turtle-bazon/PNCATEHO/light/README.md

# PNCATEHO

## PNCATEHO Welcome

### BOM

[IBOM](https://htmlpreview.github.io/?https://github.com/turtle-bazon/PNCATEHO/blob/master/light/ibom_welcome.html)

| Name | Value | Package | Quanity | JLC | Aliexpress | Misc |
| --- | --- | :--- | --- | --- | --- | --- |
| Capacitor | 1 | 0805 | 11 | [JLCPCB](https://jlcpcb.com/partdetail/39123-0805B104K500NT/C38141) | [Aliexpress](https://aliexpress.ru/item/1005008523091680.html) | |
| Capacitor | 1uF | 0805 | 4 | [JLCPCB](https://jlcpcb.com/partdetail/29074-CL21B105KBFNNNE/C28323) | [Aliexpress](https://aliexpress.ru/item/1005008523091680.html) | |
| Capacitor | 20pF | 0805 | 2 | [JLCPCB](https://jlcpcb.com/partdetail/KEMET-C0402C200K4GAC7867/C3839897) | [Aliexpress](https://aliexpress.ru/item/1005008523091680.html) | |
| Resitor | 1k | 0805 | 4 | [JLCPCB](https://jlcpcb.com/partdetail/VO-0805_1_1K/C2889437) | [Aliexpress](https://aliexpress.ru/item/1005004542788613.html)<br>  | |
| Resitor | 5.1k | 0805 | 2 | [JLCPCB](https://jlcpcb.com/partdetail/C5123602) | [Aliexpress](https://aliexpress.ru/item/1005004542788613.html)<br>  | |
| Resitor | 27Ω | 0805 | 2 | [JLCPCB](https://jlcpcb.com/partdetail/YAGEO-AC0805FR7W27RL/C5120098) | [Aliexpress](https://aliexpress.ru/item/1005004542788613.html)<br>  | |
| Resitor | 10k | 0805 | 1 | [JLCPCB](https://jlcpcb.com/partdetail/VO-0805_1_10K/C2889436) | [Aliexpress](https://aliexpress.ru/item/1005004542788613.html)<br>  | |
| LED | Red | 0805 | 1 | [JLCPCB](https://jlcpcb.com/partdetail/85425-NCD0805R1/C84256) | [Aliexpress](https://aliexpress.ru/item/4000936781234.html) | |
| LED | Blue | 0805 | 1 | [JLCPCB](https://jlcpcb.com/partdetail/Hubei_KentoElec-C2293/C2293) | [Aliexpress](https://aliexpress.ru/item/4000936781234.html) | |
| LED | WS2812B | 2020 | 20 | [JLCPCB](https://jlcpcb.com/partdetail/Worldsemi-WS2812B2020/C965555) | [Aliexpress](https://aliexpress.ru/item/1005005812058130.html)<br>  | |
| LDO | RT9013-33GB | SOT23-5 | 1 | [JLCPCB](https://jlcpcb.com/partdetail/RichtekTech-RT901333GB/C47773) | [Aliexpress](https://aliexpress.ru/item/1005009379057215.html)<br>  | |
| FLASH | W25Q32JVSSIQ | SOIC-8-208mil | 1 | [JLCPCB](https://jlcpcb.com/partdetail/WinbondElec-W25Q32JVSSIQ/C179173)<br> | [Aliexpress](https://ali.click/ja3ym8) | |
| ESD | USBLC6-2SC6 | SOT23-6 | 1 | [JLCPCB](https://jlcpcb.com/partdetail/STMicroelectronics-USBLC62SC6/C7519)<br> | [Aliexpress](https://ali.click/vl3ymq) | |
| Crystal | 12MHz 20pF | SMD3225-4P | 1 | [JLCPCB](https://jlcpcb.com/partdetail/YXC_CrystalOscillators-X322512MSB4SI/C9002)<br> | [Aliexpress](https://aliexpress.ru/item/1005006861125810.html) | |
| Fuse | 500mA 6V | 0805 | 1 | [JLCPCB](https://jlcpcb.com/partdetail/BHFUSE-BSMD0805_0506V/C883108)<br> | [Aliexpress](https://aliexpress.ru/item/1005009503064953.html) | |
| MCU | RP2040 | LQFN-56(7x7) | 1 | [JLCPCB](https://jlcpcb.com/partdetail/RaspberryPi-RP2040/C2040)<br> | [Aliexpress](https://aliexpress.ru/item/1005007523217221.html?) | |
| Type-C | TYPE-C-31-M-12 | 16P 5A Female | 1 | [JLCPCB](https://jlcpcb.com/partdetail/Korean_HropartsElec-TYPE_C_31_M12/C165948)<br>  | [Aliexpress](https://aliexpress.ru/item/1005005260008476.html?)<br> | |
| Tactile Switch | TS342A2P | SMD 4x3mm | 2 | [JLCPCB](https://jlcpcb.com/partdetail/SHOUHAN-TS342A2P/C398055) | [Aliexpress](https://ali.click/1z4ym0l)<br> | |
| Swtiches | PG1316S | SMD | 10 | [JLCPCB](https://jlcpcb.com/partdetail/Kailh-CPG1316S01D02/C42372112)<br> | | [Kailh](https://www.kailhswitch.com/mechanical-keyboard-switches/low-profile-key-switches/kailh-ultra-thin-notebook-switch.html) |
| Sockets (Optional) | PBS | PH8.5 | 10 pin  | | [Aliexpress](https://aliexpress.ru/item/1005001621924231.html)<br>  | |
| Pin (Optional) | PLS | | 10 Pin  | | [Aliexpress](https://aliexpress.ru/item/1005001708024520.html)<br>  | |
| JST (Optional) | SM10B-GHS-TB | P=1.25mm,Surface Mount，Right Angle | 2 | [JLCPCB](https://jlcpcb.com/partdetail/JST-SM10B_GHSTB/C2683602)<br> | <br> | [ChipDip](https://www.chipdip.ru/product/sm10b-ghs-tb-connector-header-surface-mount-right-angle-jst-8033862895) |
