turtle-bazon/PNCATEHO/glass/case/MK_DOSE/PNCATEHO_MK_DOSE-case-top-cover-JP-katakana-right-lp.step

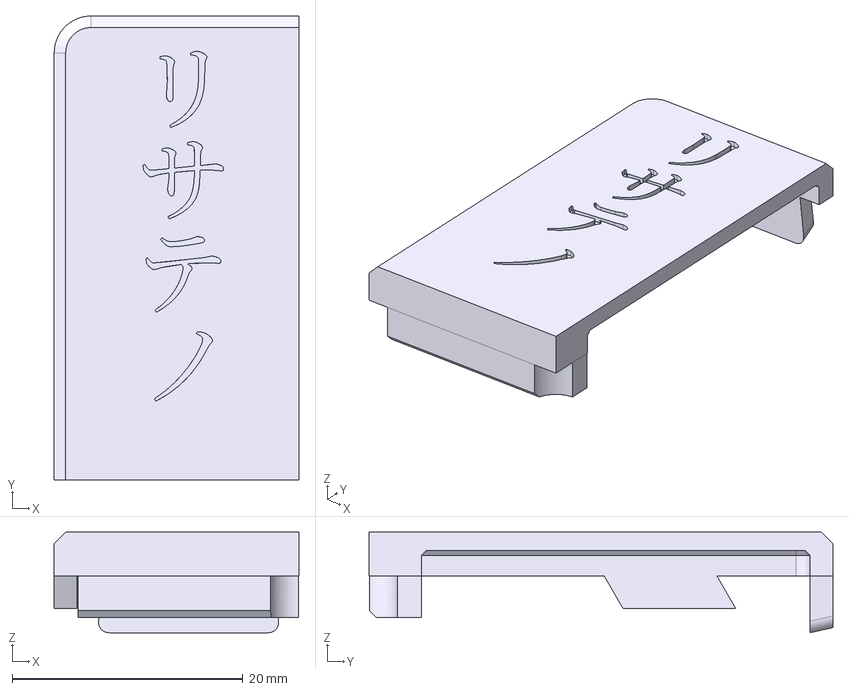
[picture p1: CAD file, 2025-09-07]
glass/case/MK_DOSE/PNCATEHO_MK_DOSE-case-top-cover-JP-katakana-right-lp.step
21.2 x 40.2 x 8.71 mm
