turtle-bazon/PNCATEHO/glass/case/v5/PNCATEHO_v5-bottom-case-left.step

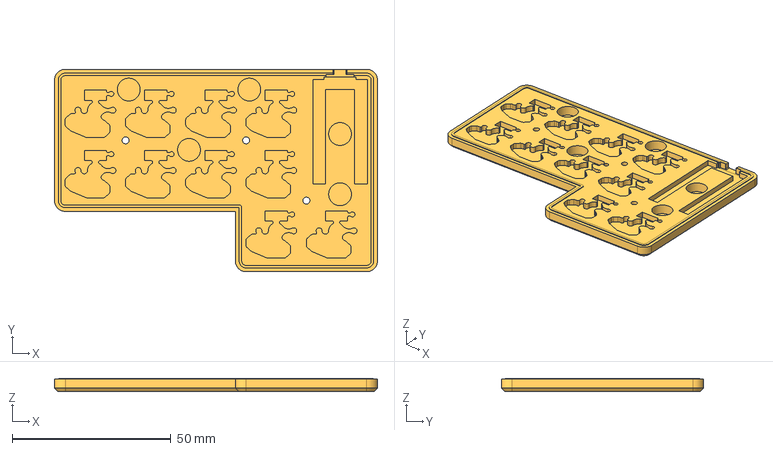
[picture p2: CAD file, 2025-08-24]
glass/case/v5/PNCATEHO_v5-bottom-case-left.step
101.8 x 63.8 x 4.20 mm
