turtle-bazon/PNCATEHO/light/pcb/PNCATEHO_lib/step/SW_SPST_B3U-1000P-B.step

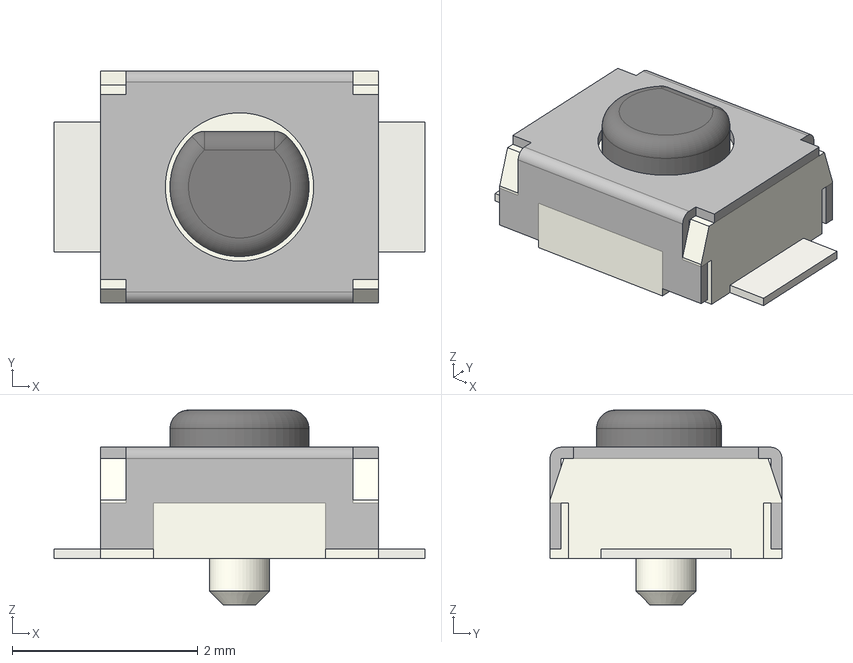
[picture p3: CAD file, 2025-08-21]
light/pcb/PNCATEHO_lib/step/SW_SPST_B3U-1000P-B.step
4.00 x 2.50 x 2.10 mm
