turtle-bazon/PNCATEHO/light/pcb/PNCATEHO_lib/step/Fuse_0805_2012Metric.step

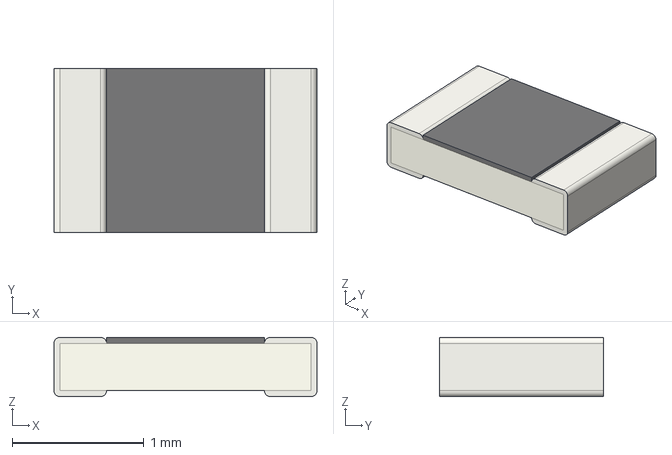
[picture p6: CAD file, 2025-08-20]
light/pcb/PNCATEHO_lib/step/Fuse_0805_2012Metric.step
2.00 x 1.25 x 0.45 mm
