turtle-bazon/PNCATEHO/light/pcb/PNCATEHO_lib/step/TYPE-C-31-M-12--3DModel-STEP-56544.STEP

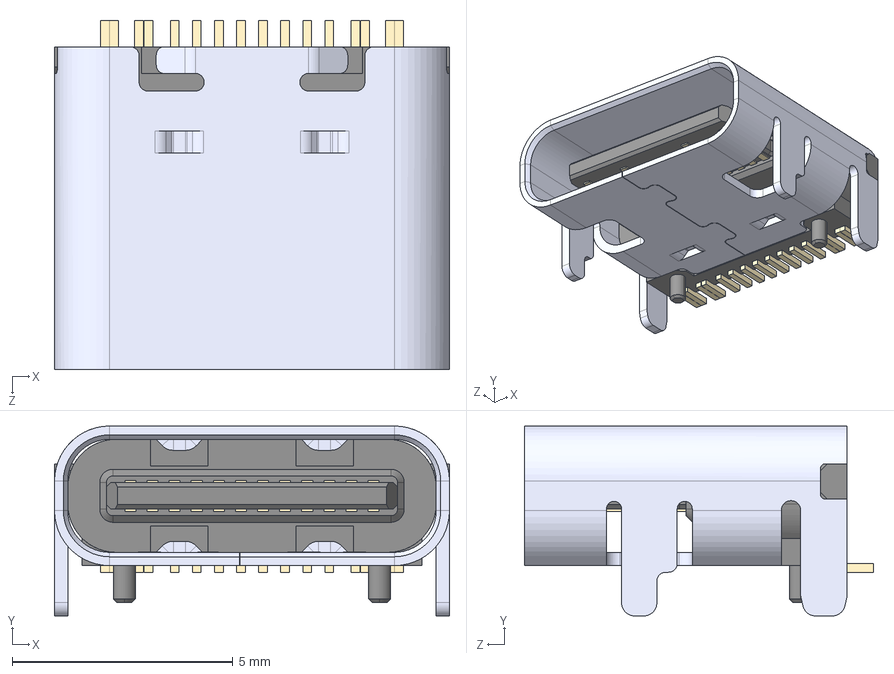
[picture p7: CAD file, 2025-08-20]
light/pcb/PNCATEHO_lib/step/TYPE-C-31-M-12--3DModel-STEP-56544.STEP
8.94 x 4.30 x 7.90 mm
