turtle-bazon/PNCATEHO/light/pcb/PNCATEHO_lib/step/W25Q32JVSSIQ--3DModel-STEP-269445.STEP

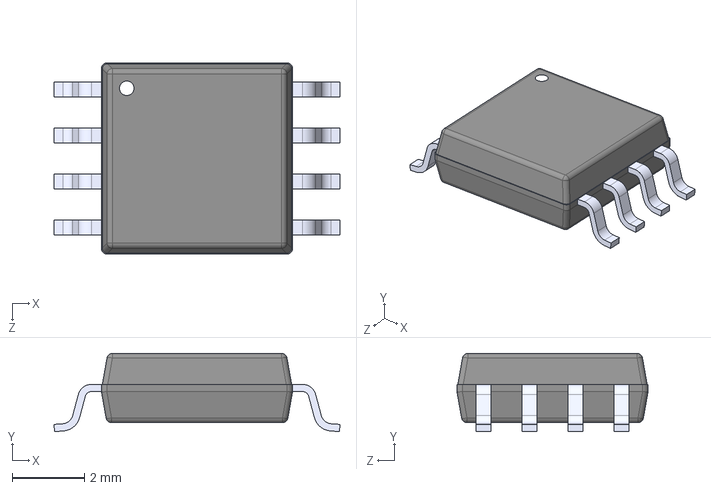
[picture p9: CAD file, 2025-08-20]
light/pcb/PNCATEHO_lib/step/W25Q32JVSSIQ--3DModel-STEP-269445.STEP
7.90 x 2.16 x 5.28 mm
