turtle-bazon/PNCATEHO/light/pcb/PNCATEHO_lib/step/D_0805_2012Metric.step

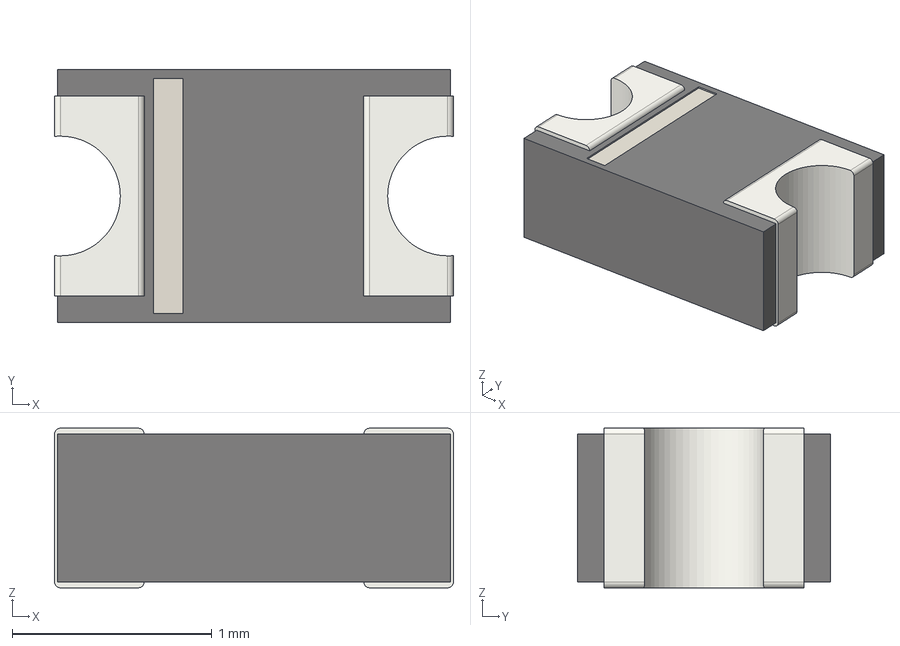
[picture p10: CAD file, 2025-08-20]
light/pcb/PNCATEHO_lib/step/D_0805_2012Metric.step
2.00 x 1.27 x 0.8 mm
