turtle-bazon/PNCATEHO/light/pcb/PNCATEHO_lib/step/RT9013-33GB.STEP

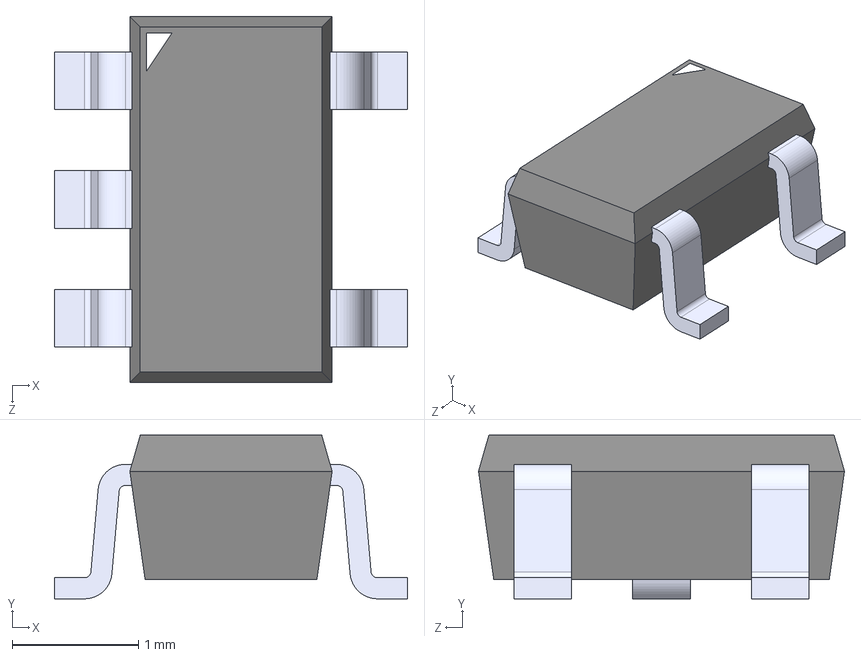
[picture p12: CAD file, 2025-08-20]
light/pcb/PNCATEHO_lib/step/RT9013-33GB.STEP
2.79 x 1.30 x 2.90 mm
