turtle-bazon/PNCATEHO/light/pcb/PNCATEHO_lib/step/Crystal_SMD_3225-4Pin_3.2x2.5mm.step

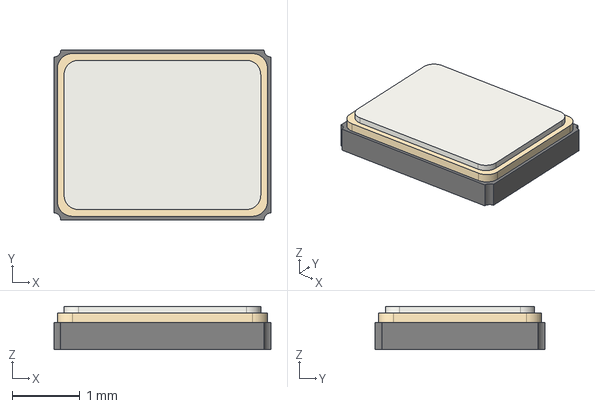
[picture p13: CAD file, 2025-08-20]
light/pcb/PNCATEHO_lib/step/Crystal_SMD_3225-4Pin_3.2x2.5mm.step
3.20 x 2.50 x 0.64 mm
