turtle-bazon/PNCATEHO/light/pcb/PNCATEHO_lib/step/R_0805_2012Metric.step

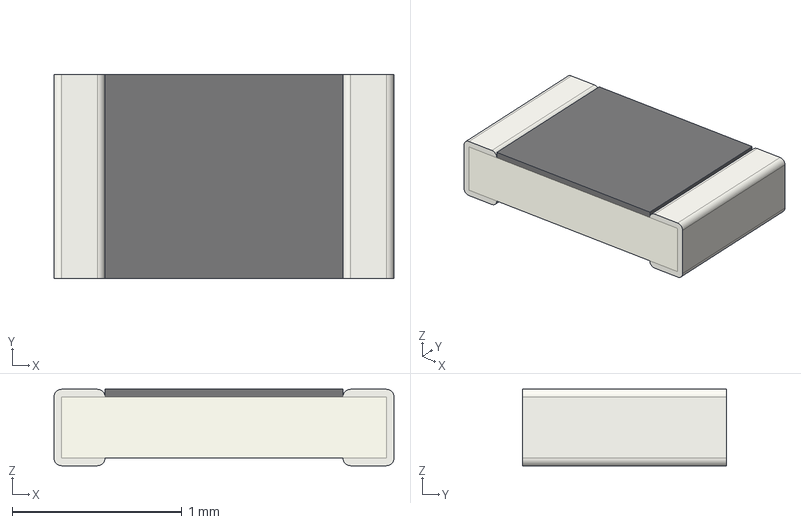
[picture p16: CAD file, 2025-08-20]
light/pcb/PNCATEHO_lib/step/R_0805_2012Metric.step
2.00 x 1.20 x 0.45 mm
