turtle-bazon/PNCATEHO/(list of files, cad)

Other CAD files:
glass/case/v5/PNCATEHO_v5-bottom-case-right.step
glass/case/MK_DOSE/PNCATEHO_MK_DOSE-case-top-cover-JP-katakana-left-lp.step
glass/case/MK_DOSE/PNCATEHO_MK_DOSE-case-top-cover-blank-right-lp.step
glass/case/MK_DOSE/PNCATEHO_MK_DOSE-case-bottom-left.step
