turtle-bazon/PNCATEHO/light/pcb/PNCATEHO_Welcome/PNCATEHO_Welcome.kicad_pcb

## KiCad design light/pcb/PNCATEHO_Welcome/PNCATEHO_Welcome.kicad_pcb (2025-10-24)

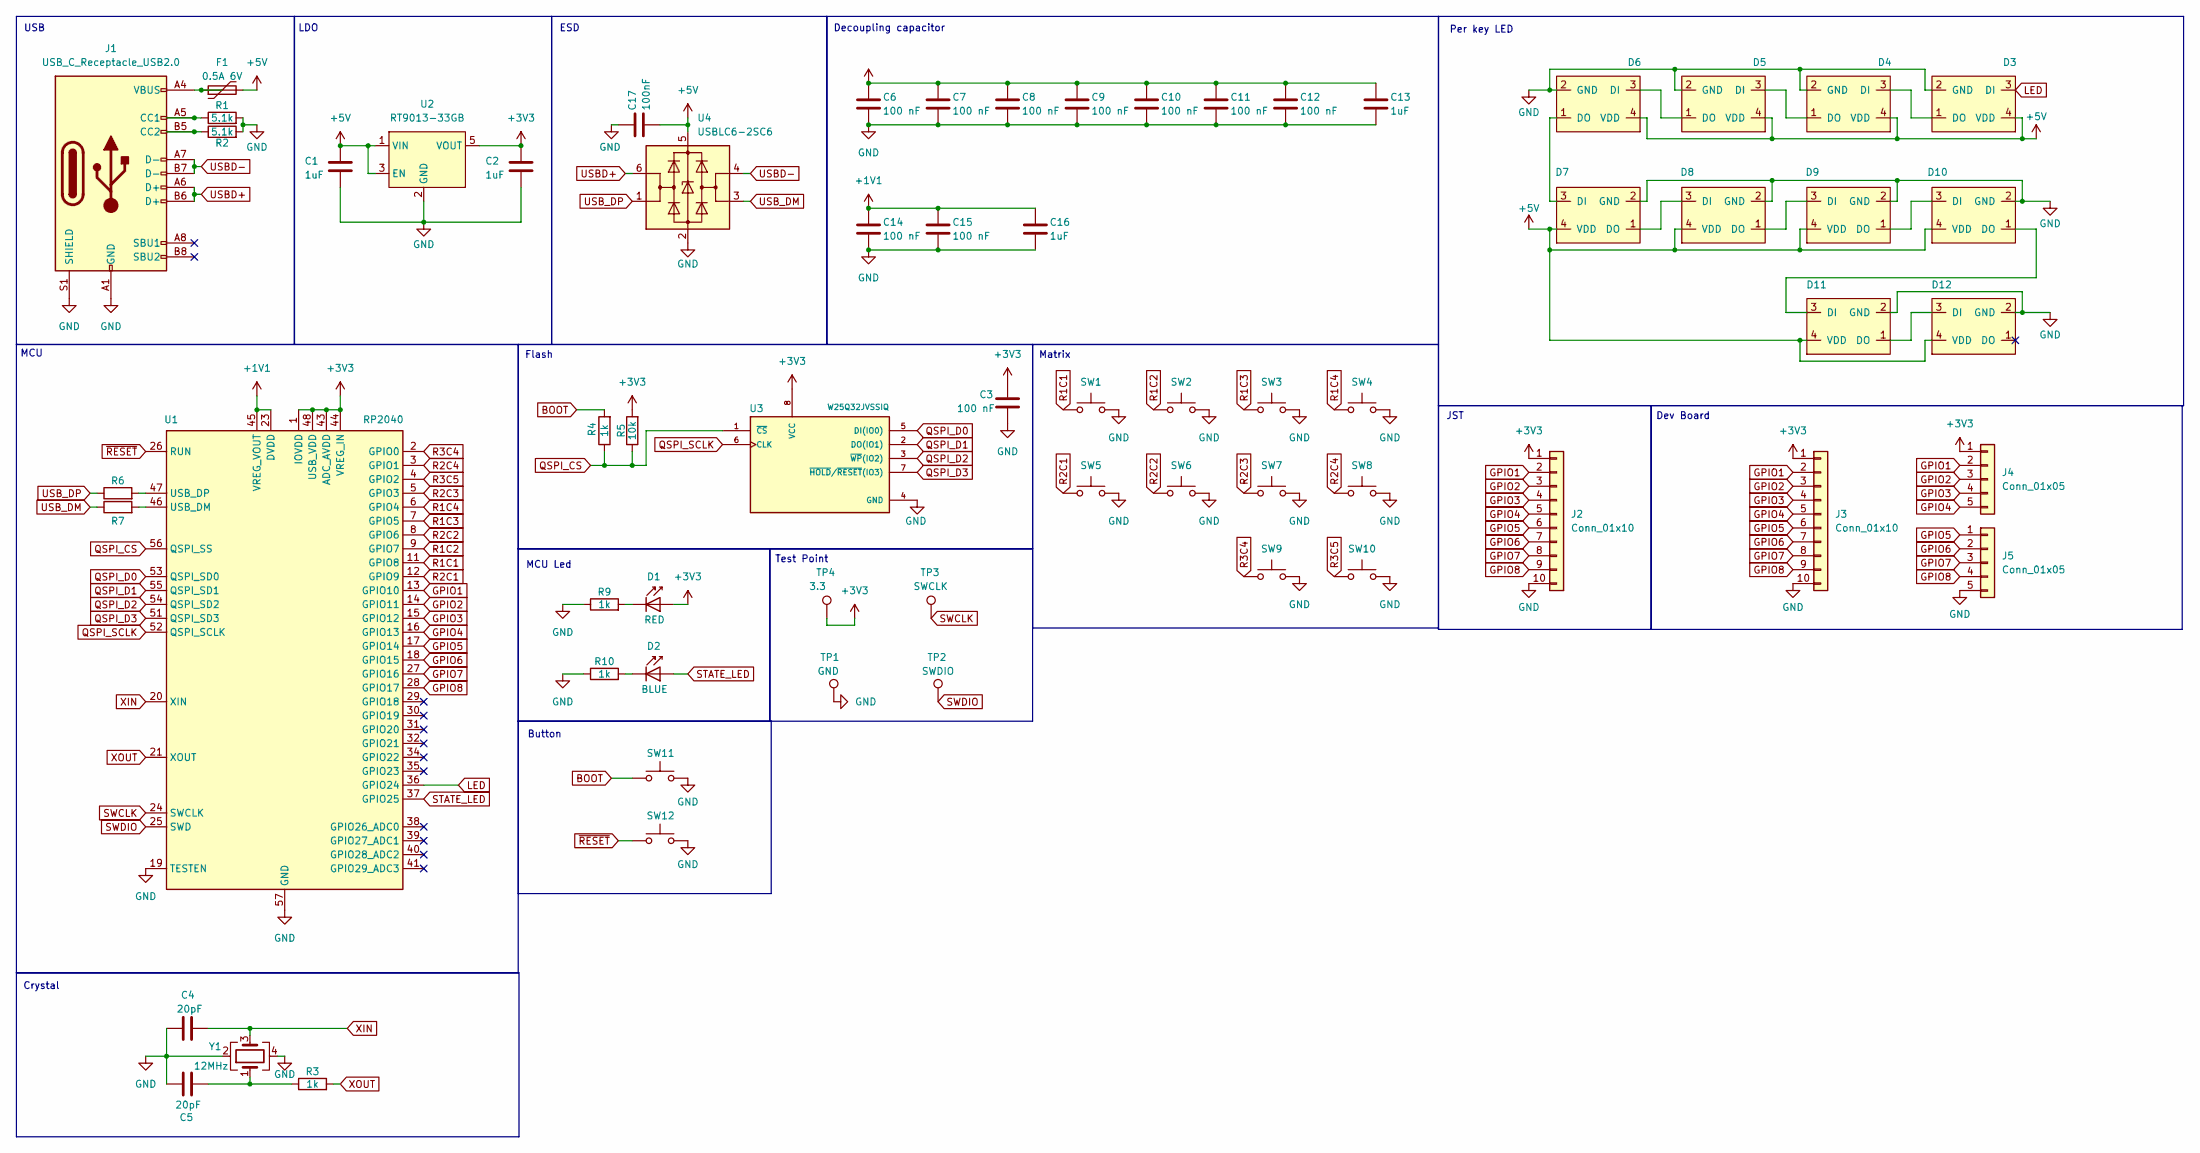
[picture p17: schematic PNCATEHO_Welcome.kicad_sch]

Parts:
C1, C2, C13, C16: 1uF; C_0805_2012Metric_Pad1.18x1.45mm_HandSolder
C3, C6, C7, C8, C9, C10, C11, C12, C14, C15: 100 nF; C_0805_2012Metric_Pad1.18x1.45mm_HandSolder
C4, C5: 20pF; C_0805_2012Metric_Pad1.18x1.45mm_HandSolder
C17: 100nF; C_0805_2012Metric_Pad1.18x1.45mm_HandSolder
D1: RED; LED_0805_2012Metric_Pad1.15x1.40mm_HandSolder
D2: BLUE; LED_0805_2012Metric_Pad1.15x1.40mm_HandSolder
D3, D4, D5, D6, D7, D8, D9, D10, D11, D12: WS2812-2020-2.00mmx2.20mm
F1: 0.5А 6V; Fuse_0805_2012Metric_Pad1.15x1.40mm_HandSolder
J1: USB_C_Receptacle_USB2.0; USB_C_Receptacle_TYPE-C-31-M-12
J2, J3: Conn_01x10; JST_GH_SM10B-GHS-TB_1x10-1MP_P1.25mm_Horizontal
J4, J5: Conn_01x05; PinHeader_1x05_P2.54mm_Vertical
R1, R2: 5.1k; R_0805_2012Metric_Pad1.20x1.40mm_HandSolder
R3, R4, R9, R10: 1k; R_0805_2012Metric_Pad1.20x1.40mm_HandSolder
R5: 10k; R_0805_2012Metric_Pad1.20x1.40mm_HandSolder
R6, R7: 27; R_0805_2012Metric_Pad1.20x1.40mm_HandSolder
SW1, SW2, SW3, SW4, SW5, SW6, SW7, SW8, SW9, SW10: SW_PG1316
SW11: Boot; SW_PUSH
SW12: Reset; SW_PUSH
TP1: GND; TestPoint_Pad_1.0x1.0mm
TP2: SWDIO; TestPoint_Pad_D1.0mm
TP3: SWCLK; TestPoint_Pad_D1.0mm
TP4: 3.3; TestPoint_Pad_D1.0mm
U1: RP2040; QFN-56-1EP_7x7mm_P0.4mm_EP3.2x3.2mm_ThermalVias
U2: RT9013-33GB; SOT-23-5_HandSoldering
U3: W25Q32JVSSIQ; SOIC-8_5.3x5.3mm_P1.27mm; M_PART_NUMBER W25QXX
U4: USBLC6-2SC6; SOT-23-6_Handsoldering
Y1: 12MHz; Crystal_SMD_3225-4Pin_3.2x2.5mm_HandSoldering

Connections:
+1V1: C14.1, C15.1, C16.1, U1.23 (DVDD), U1.45 (VREG_VOUT), U1.50 (DVDD)
+3V3: C2.1, C3.1, C6.1, C7.1, C8.1, C9.1, C10.1, C11.1, C12.1, C13.1, D1.2 (A), J2.1, J3.1, J4.1, R5.2, TP4.1, U1.1 (IOVDD), U1.10 (IOVDD), U1.22 (IOVDD), U1.33 (IOVDD), U1.42 (IOVDD), U1.43 (ADC_AVDD), U1.44 (VREG_IN), U1.48 (USB_VDD), U1.49 (IOVDD), U2.5 (VOUT), U3.8 (VCC)
+5V: C1.1, C17.2, D3.4 (VDD), D4.4 (VDD), D5.4 (VDD), D6.4 (VDD), D7.4 (VDD), D8.4 (VDD), D9.4 (VDD), D10.4 (VDD), D11.4 (VDD), D12.4 (VDD), F1.2, U2.1 (VIN), U2.3 (EN), U4.5 (VBUS)
BOOT: R4.2, SW11.2
GND: C1.2, C2.2, C3.2, C4.2, C5.2, C6.2, C7.2, C8.2, C9.2, C10.2, C11.2, C12.2, C13.2, C14.2, C15.2, C16.2, C17.1, D3.2 (GND), D4.2 (GND), D5.2 (GND), D6.2 (GND), D7.2 (GND), D8.2 (GND), D9.2 (GND), D10.2 (GND), D11.2 (GND), D12.2 (GND), J1.A1 (GND), J1.A12 (GND), J1.B1 (GND), J1.B12 (GND), J1.S1 (SHIELD), J2.10, J3.10, J5.5, R1.2, R2.2, R9.1, R10.1, SW1.2, SW2.2, SW3.2, SW4.2, SW5.2, SW6.2, SW7.2, SW8.2, SW9.2, SW10.2, SW11.1, SW12.1, TP1.1, U1.19 (TESTEN), U1.57 (GND), U2.2 (GND), U3.4 (GND), U4.2 (GND), Y1.2, Y1.4
GPIO1: J2.2, J3.2, J4.2, U1.13 (GPIO10)
GPIO2: J2.3, J3.3, J4.3, U1.14 (GPIO11)
GPIO3: J2.4, J3.4, J4.4, U1.15 (GPIO12)
GPIO4: J2.5, J3.5, J4.5, U1.16 (GPIO13)
GPIO5: J2.6, J3.6, J5.1, U1.17 (GPIO14)
GPIO6: J2.7, J3.7, J5.2, U1.18 (GPIO15)
GPIO7: J2.8, J3.8, J5.3, U1.27 (GPIO16)
GPIO8: J2.9, J3.9, J5.4, U1.28 (GPIO17)
LED: D3.3 (DI), U1.36 (GPIO24)
unnamed: C5.1, R3.1, Y1.1
unnamed: D1.1 (K), R9.2
unnamed: D2.1 (K), R10.2
unnamed: D3.1 (DO), D4.3 (DI)
unnamed: D4.1 (DO), D5.3 (DI)
unnamed: D5.1 (DO), D6.3 (DI)
unnamed: D6.1 (DO), D7.3 (DI)
unnamed: D7.1 (DO), D8.3 (DI)
unnamed: D8.1 (DO), D9.3 (DI)
unnamed: D9.1 (DO), D10.3 (DI)
unnamed: D10.1 (DO), D11.3 (DI)
unnamed: D11.1 (DO), D12.3 (DI)
unnamed: F1.1, J1.A4 (VBUS), J1.A9 (VBUS), J1.B4 (VBUS), J1.B9 (VBUS)
unnamed: J1.A5 (CC1), R1.1
unnamed: J1.B5 (CC2), R2.1
unnamed: R7.2, U1.46 (USB_DM)
unnamed: R6.2, U1.47 (USB_DP)
QSPI_CS: R4.1, R5.1, U1.56 (QSPI_SS), U3.1 (~CS)
QSPI_D0: U1.53 (QSPI_SD0), U3.5 (DI(IO0))
QSPI_D1: U1.55 (QSPI_SD1), U3.2 (DO(IO1))
QSPI_D2: U1.54 (QSPI_SD2), U3.3 (~WP(IO2))
QSPI_D3: U1.51 (QSPI_SD3), U3.7 (~HOLD/~RESET(IO3))
QSPI_SCLK: U1.52 (QSPI_SCLK), U3.6 (CLK)
R1C1: SW1.1, U1.11 (GPIO8)
R1C2: SW2.1, U1.9 (GPIO7)
R1C3: SW3.1, U1.7 (GPIO5)
R1C4: SW4.1, U1.6 (GPIO4)
R2C1: SW5.1, U1.12 (GPIO9)
R2C2: SW6.1, U1.8 (GPIO6)
R2C3: SW7.1, U1.5 (GPIO3)
R2C4: SW8.1, U1.3 (GPIO1)
R3C4: SW9.1, U1.2 (GPIO0)
R3C5: SW10.1, U1.4 (GPIO2)
STATE_LED: D2.2 (A), U1.37 (GPIO25)
SWCLK: TP3.1, U1.24 (SWCLK)
SWDIO: TP2.1, U1.25 (SWD)
USBD+: J1.A6 (D+), J1.B6 (D+), U4.6 (I/O1)
USBD-: J1.A7 (D-), J1.B7 (D-), U4.4 (I/O2)
USB_DM: R7.1, U4.3 (I/O2)
USB_DP: R6.1, U4.1 (I/O1)
XIN: C4.1, U1.20 (XIN), Y1.3
XOUT: R3.2, U1.21 (XOUT)
~RESET: SW12.2, U1.26 (RUN)

Notes on the sheet:
ESD
Test Point
Per key LED
MCU Led
Dev Board
Crystal
USB
MCU
Flash
LDO
Decoupling capacitor
JST
Button
Matrix

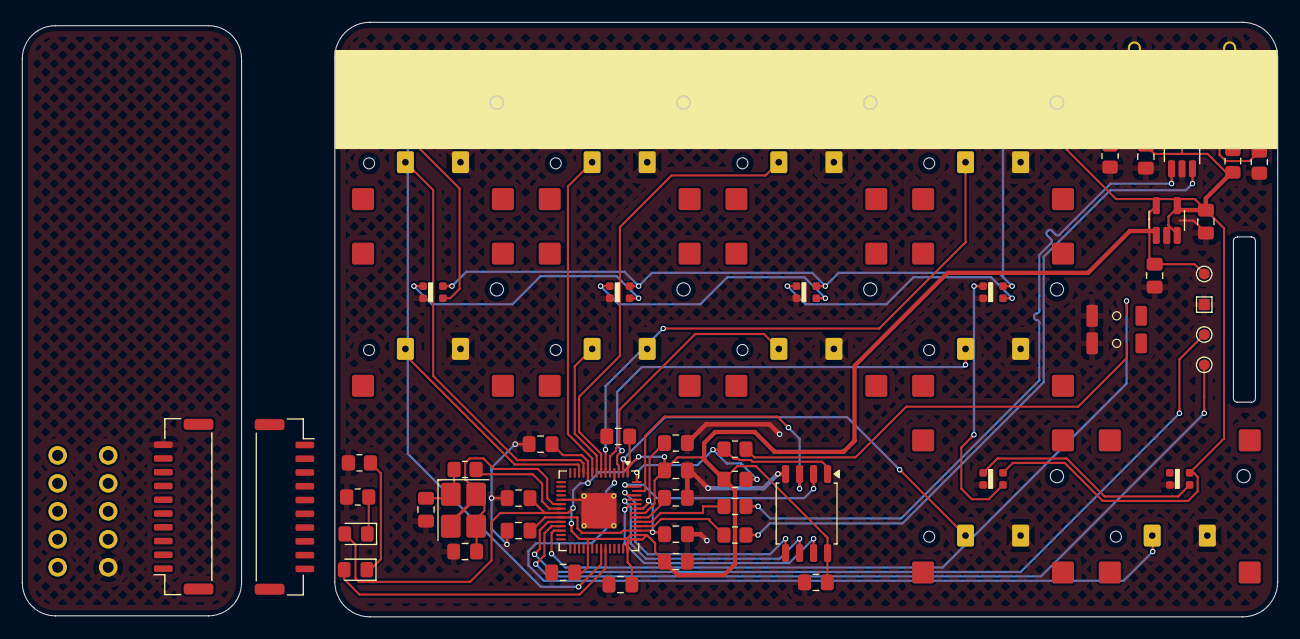
[picture p18: board PNCATEHO_Welcome.kicad_pcb from above]

Board: 2 copper layers, 85.6 x 54.0 mm, 65 parts (0 on the bottom side), 57 nets.
