turtle-bazon/PNCATEHO/light/pcb/PNCATEHO_lowair/PNCATEHO_lowair.kicad_pcb

## KiCad design light/pcb/PNCATEHO_lowair/PNCATEHO_lowair.kicad_pcb (2025-10-20)

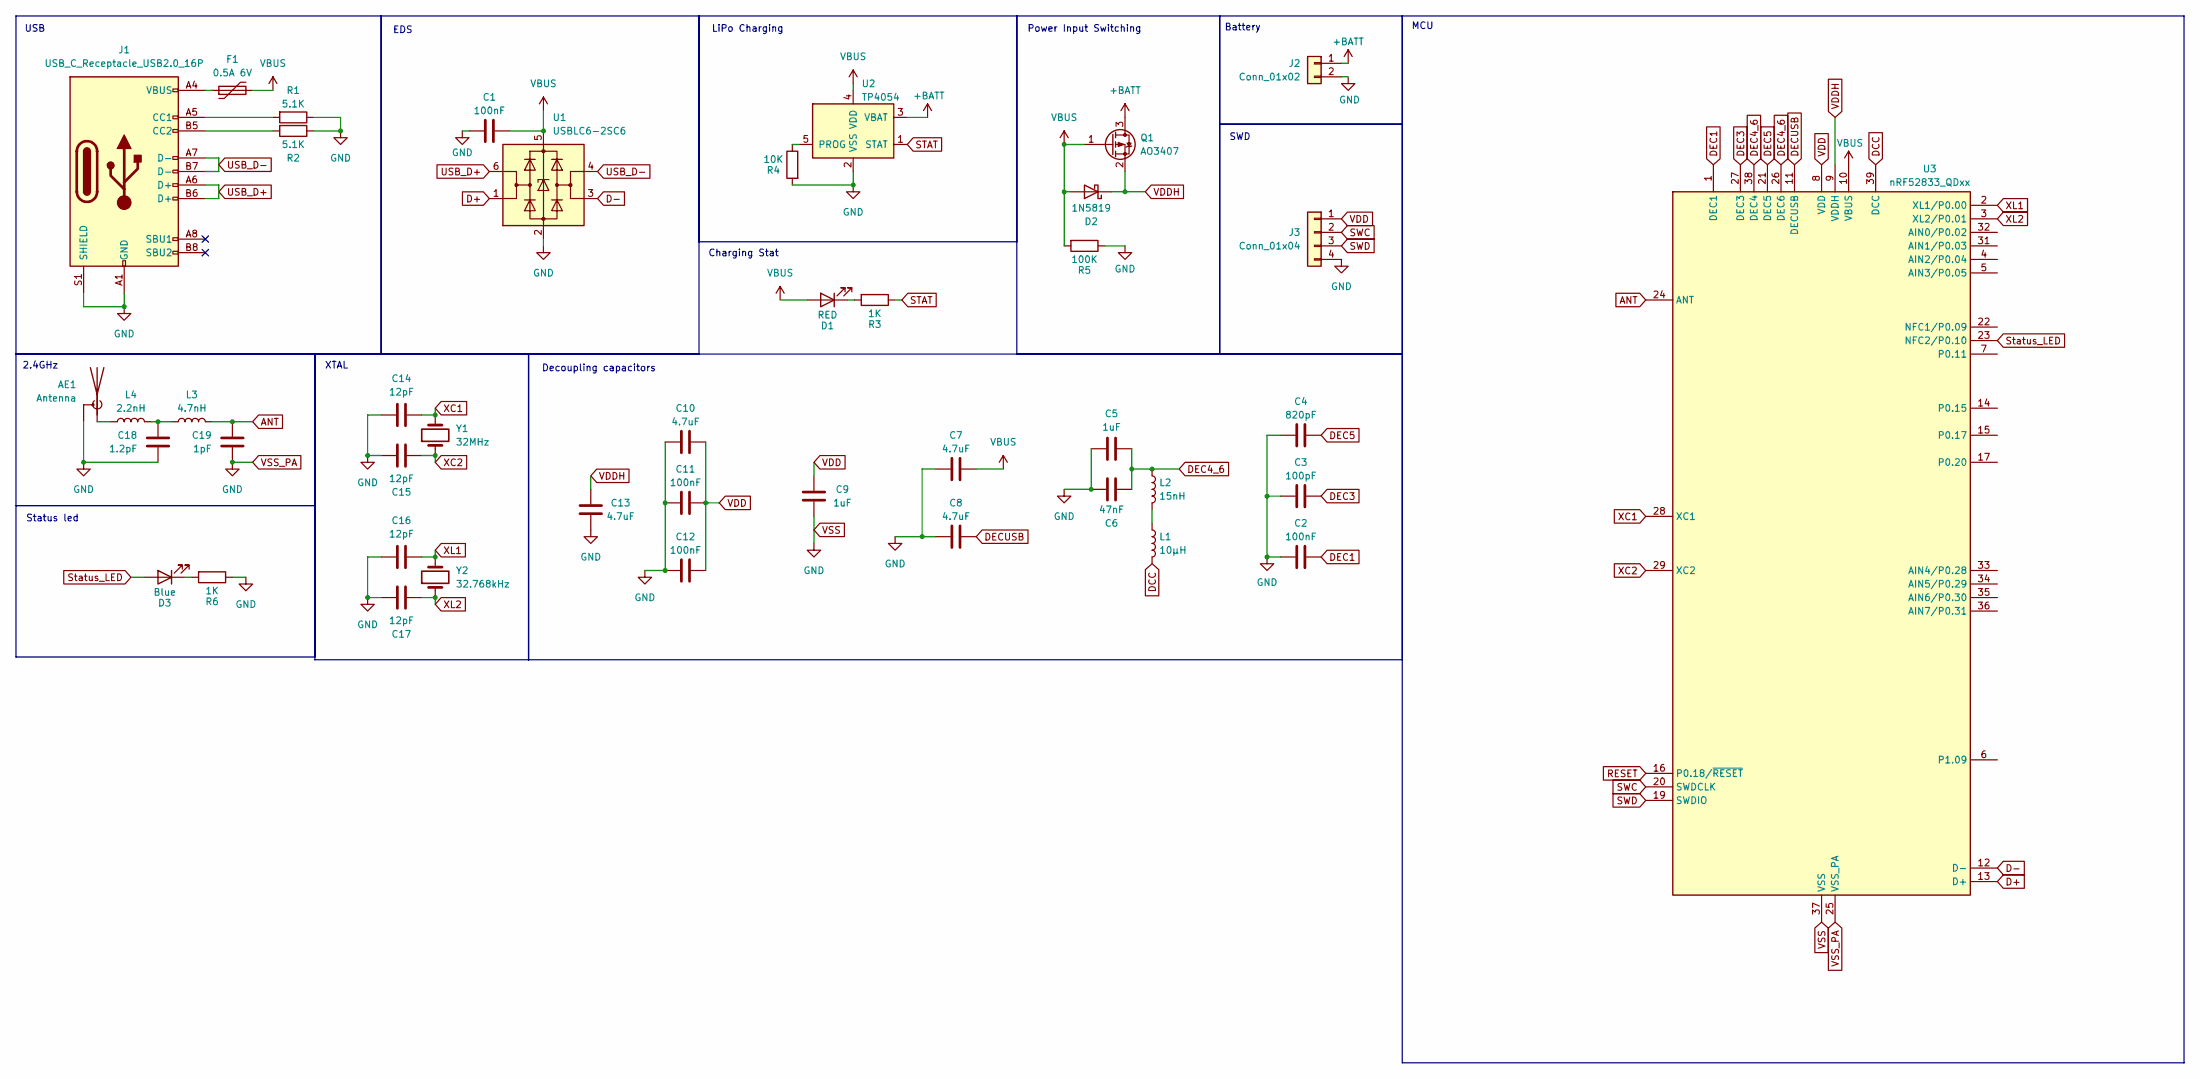
[picture p19: schematic PNCATEHO_lowair.kicad_sch]

Parts:
AE1: Antenna; Texas_SWRA117D_2.4GHz_Left
C1, C2, C11, C12: 100nF; C_0201_0603Metric_Pad0.64x0.40mm_HandSolder
C3: 100pF; C_0201_0603Metric_Pad0.64x0.40mm_HandSolder
C4: 820pF; C_0201_0603Metric_Pad0.64x0.40mm_HandSolder
C5, C9: 1uF; C_0402_1005Metric_Pad0.74x0.62mm_HandSolder
C6: 47nF; C_0201_0603Metric_Pad0.64x0.40mm_HandSolder
C7, C8, C10, C13: 4.7uF; C_0603_1608Metric_Pad1.08x0.95mm_HandSolder
C14, C15, C16, C17: 12pF; C_0201_0603Metric_Pad0.64x0.40mm_HandSolder
C18: 1.2pF; C_0201_0603Metric_Pad0.64x0.40mm_HandSolder
C19: 1pF; C_0201_0603Metric_Pad0.64x0.40mm_HandSolder
D1: RED; LED_0805_2012Metric_Pad1.15x1.40mm_HandSolder
D2: 1N5819; D_SOD-323_HandSoldering
D3: Blue; LED_0805_2012Metric_Pad1.15x1.40mm_HandSolder
F1: 0.5А 6V; Fuse_1206_3216Metric_Pad1.42x1.75mm_HandSolder
J1: USB_C_Receptacle_USB2.0_16P; USB_C_Receptacle_TYPE-C-31-M-12
J2: Conn_01x02
J3: Conn_01x04; connector_swd_REV
L1: 10μH; L_0603_1608Metric_Pad1.05x0.95mm_HandSolder
L2: 15nH; L_0402_1005Metric_Pad0.77x0.64mm_HandSolder
L3: 4.7nH; L_0201_0603Metric_Pad0.64x0.40mm_HandSolder
L4: 2.2nH; L_0201_0603Metric_Pad0.64x0.40mm_HandSolder
Q1: AO3407; SOT-23
R1, R2: 5.1K; R_0603_1608Metric_Pad0.98x0.95mm_HandSolder
R3, R6: 1K; R_0603_1608Metric_Pad0.98x0.95mm_HandSolder
R4: 10K; R_0603_1608Metric_Pad0.98x0.95mm_HandSolder
R5: 100K; R_0603_1608Metric_Pad0.98x0.95mm_HandSolder
U1: USBLC6-2SC6; SOT-23-6
U2: TP4054; SOT-23-5
U3: nRF52833_QDxx; QFN-40-1EP_5x5mm_P0.4mm_EP3.6x3.6mm_ThermalVias
Y1: 32MHz
Y2: 32.768kHz

Connections:
+BATT: J2.1, Q1.3 (D), U2.3 (VBAT)
ANT: C19.2, L3.1, U3.24 (ANT)
D+: U1.1 (I/O1), U3.13 (D+)
D-: U1.3 (I/O2), U3.12 (D-)
DCC: L1.2, U3.39 (DCC)
DEC1: C2.2, U3.1 (DEC1)
DEC3: C3.2, U3.27 (DEC3)
DEC4_6: C5.2, C6.2, L2.1, U3.26 (DEC6), U3.38 (DEC4)
DEC5: C4.2, U3.21 (DEC5)
DECUSB: C8.2, U3.11 (DECUSB)
unnamed: AE1.1 (A), L4.2
unnamed: C18.1, L3.2, L4.1
unnamed: D1.1 (K), R3.2
unnamed: D3.1 (K), R6.2
unnamed: F1.1, J1.A4 (VBUS), J1.A9 (VBUS), J1.B4 (VBUS), J1.B9 (VBUS)
unnamed: J1.A5 (CC1), R1.2
unnamed: J1.B5 (CC2), R2.2
unnamed: L1.1, L2.2
unnamed: R4.1, U2.5 (PROG)
RESET: U3.16 (P0.18/~RESET)
STAT: R3.1, U2.1 (STAT)
SWC: J3.2, U3.20 (SWDCLK)
SWD: J3.3, U3.19 (SWDIO)
Status_LED: D3.2 (A), U3.23 (NFC2/P0.10)
USB_D+: J1.A6 (D+), J1.B6 (D+), U1.6 (I/O1)
USB_D-: J1.A7 (D-), J1.B7 (D-), U1.4 (I/O2)
VBUS: C1.2, C7.2, D1.2 (A), D2.2 (A), F1.2, Q1.1 (G), R5.2, U1.5 (VBUS), U2.4 (VDD), U3.10 (VBUS)
VDD: C9.1, C10.2, C11.2, C12.2, J3.1, U3.8 (VDD), U3.18 (VDD), U3.30 (VDD), U3.40 (VDD)
VDDH: C13.1, D2.1 (K), Q1.2 (S), U3.9 (VDDH)
VSS: AE1.2 (Shield), C1.1, C2.1, C3.1, C4.1, C5.1, C6.1, C7.1, C8.1, C9.2, C10.1, C11.1, C12.1, C13.2, C14.1, C15.2, C16.1, C17.2, C18.2, C19.1, J1.A1 (GND), J1.A12 (GND), J1.B1 (GND), J1.B12 (GND), J1.S1 (SHIELD), J2.2, J3.4, R1.1, R2.1, R4.2, R5.1, R6.1, U1.2 (GND), U2.2 (VSS), U3.25 (VSS_PA), U3.37 (VSS), U3.41 (VSS)
XC1: C14.2, U3.28 (XC1), Y1.2
XC2: C15.1, U3.29 (XC2), Y1.1
XL1: C16.2, U3.2 (XL1/P0.00), Y2.2
XL2: C17.1, U3.3 (XL2/P0.01), Y2.1

Notes on the sheet:
EDS
Status led
Power Input Switching
USB
LiPo Charging
XTAL
2.4GHz
Charging Stat
SWD
Battery
Decoupling capacitors
MCU

Board: 2 copper layers, 40 parts (0 on the bottom side), 33 nets, no tracks yet.
