turtle-bazon/PNCATEHO/(commit log)

2025-08-20 upload sheme
    [PNCATEHO.kicad_pcb, PNCATEHO.kicad_sch]
2025-08-21 PGS1316s PNCATEHO basic routing
    [PNCATEHO.kicad_pcb, PNCATEHO.kicad_sch]
2025-08-21 update routin
    [PNCATEHO.kicad_pcb]
2025-08-21 update silkscreen
2025-08-21 update solid
    [PNCATEHO.kicad_pcb]
2025-08-21 update step
    [PNCATEHO.kicad_pcb]
2025-08-21 fix footprint
    [PNCATEHO.kicad_pcb]
2025-08-22 update outline
    [PNCATEHO.kicad_pcb, PNCATEHO.kicad_sch]
2025-08-24 Change default Silicone Pad Diameter to 8mm
    [PNCATEHO_MK_DOSE-case-bottom-left.step, PNCATEHO_MK_DOSE-case-bottom-right.step, PNCATEHO_v5-bottom-case-left.step, PNCATEHO_v5-bottom-case-right.step]
2025-08-24 Some little fixes
    [PNCATEHO.kicad_pcb, PNCATEHO.kicad_sch]
2025-08-25 Add production files to ignore
    [PNCATEHO.kicad_pcb]
2025-08-28 add esd protection
    [PNCATEHO.kicad_pcb, PNCATEHO.kicad_sch]
2025-08-28 add some fix
    [PNCATEHO.kicad_pcb, PNCATEHO.kicad_sch]
2025-08-28 remove reset button
    [PNCATEHO.kicad_pcb, PNCATEHO.kicad_sch]
2025-08-28 change design
    [PNCATEHO.kicad_pcb]
2025-08-28 remove led
    [PNCATEHO.kicad_pcb, PNCATEHO.kicad_sch]
2025-08-28 add button
    [PNCATEHO.kicad_pcb, PNCATEHO.kicad_sch]
2025-08-29 * components moved closer to each other; * rerouted with esd protection; * fixed usb data differential pair length; * changed design to be like a credit card;
    [PNCATEHO.kicad_pcb, PNCATEHO.kicad_sch]
2025-08-29 update design
    [PNCATEHO.kicad_pcb]
2025-08-29 Tune differential pair (USB data) lengths
    [PNCATEHO.kicad_pcb]
2025-09-02 rename project
    [C_0805_2012Metric.step, Crystal_SMD_3225-4Pin_3.2x2.5mm.step, D_0805_2012Metric.step, Fuse_0805_2012Metric.step, LED_0805_2012Metric.step, PG1316S.STEP, PNCATEHO_Welcome.kicad_pcb, PNCATEHO_Welcome.kicad_sch]
2025-09-02 clear sch
    [PNCATEHO_Welcome.kicad_sch]
2025-09-09 fix silc
    [PNCATEHO_Welcome.kicad_pcb]
2025-09-09 add led
    [PNCATEHO_Welcome.kicad_pcb, PNCATEHO_Welcome.kicad_sch]
2025-09-10 fix sh
    [PNCATEHO_Welcome.kicad_pcb, PNCATEHO_Welcome.kicad_sch]
2025-09-20 PNCATEHO Welcome RGB routing
    [PNCATEHO_Welcome.kicad_pcb, PNCATEHO_Welcome.kicad_sch]
2025-09-22 Return state led to GPIO25
    [PNCATEHO_Welcome.kicad_pcb, PNCATEHO_Welcome.kicad_sch]
2025-10-17 upload lowair source
    [PNCATEHO_lowair.kicad_pcb, PNCATEHO_lowair.kicad_sch, power.kicad_sch]
2025-10-20 JST1.25 footprint
2025-10-20 update footprint
2025-10-20 update scheme
    [PNCATEHO_Welcome.kicad_sch]
2025-10-24 update sh
    [PNCATEHO_Welcome.kicad_sch]
2025-10-24 update footpint
    [PNCATEHO_Welcome.kicad_sch]
2025-10-24 update pcb
    [PNCATEHO_Welcome.kicad_pcb]
2025-10-24 add BOM
2025-10-24 update BOM
