turtle-bazon/PNCATEHO/(notices)

Notices in the files:
light/pcb/PNCATEHO_lib/step/R_0805_2012Metric.step:
Copyright (C) 2018, kicad StepUp
This work is licensed under the [Creative Commons CC-BY-SA 4.0 License](https://creativecommons.org/licenses/by-sa/4.0/legalcode),
with the following exception:
To the extent that the creation of electronic designs that use 'Licensed Material' can be considered to be 'Adapted Material',
You are free to use the library data in your own projects without the obligation to share your project files under this or any other license agreement.
light/pcb/PNCATEHO_lib/step/C_0805_2012Metric.step:
Copyright (C) 2017, kicad StepUp
light/pcb/PNCATEHO_lib/step/D_0805_2012Metric.step:
This program is free software: you can redistribute it and/or modify
it under the terms of the GNU General Public License as published by
the Free Software Foundation, either version 3 of the License, or
any later version.
itself might be covered by the GNU General Public License.
light/pcb/PNCATEHO_lib/step/Fuse_0805_2012Metric.step:
Copyright (C) 2020, kicad StepUp
light/pcb/PNCATEHO_lib/step/SW_SPST_B3U-1000P-B.step:
Copyright (C) 2025, KiCAD
This work is licensed under the
[Creative Commons CC-BY-SA 4.0 License](https://creativecommons.org/licenses/by-sa/4.0/legalcode),
project files under this or any other license agreement. However, if you wish to distribute
light/pcb/PNCATEHO_lib/step/QFN-56-1EP_7x7mm_P0.4mm_EP4x4mm.step:
Copyright (C) 2022, KiCAD
